priyanshupanchal20/MineVision---Guardian/firmware/README.md

# ESP32-S3 firmware

- `src/main.cpp` — integrated hub (PlatformIO)
- `include/config.h` — pins and thresholds
- `tests/` — Phase 2 single-sensor sketches

```
pio run -t upload
pio device monitor
```
