priyanshupanchal20/MineVision---Guardian/hardware/BOM.md

# Bill of materials (what you already have + consumables)

| Item | Qty | Role |
|---|---|---|
| ESP32-S3-WROOM-N16R8 Dual USB-C | 1 | Vehicle hub |
| TFMini-S | 1 | Forward LiDAR |
| HC-SR04 | 2 | Left / right |
| MLX90640 55° | 1 | Thermal on Pi |
| NEO-6M + ceramic antenna | 1 | Coarse GPS |
| BME280 | 1 | T/RH/P |
| OV7670 | 1 | Stretch; USB webcam preferred for demo |
| LM393 LDR | 1 | Ambient light |
| Waveshare 24 GHz S3KM1110 | 1 | Presence |
| Raspberry Pi 3 B 1 GB | 1 | Fusion + dashboard |
| USB webcam (recommended extra) | 1 | Visibility metrics |
| 5 V 3 A supply / power bank | 1 | Shared rail |
| AMS1117-3.3 (if radar browns out) | 1 | Dedicated 3.3 V |
| 2.2 kΩ + 3.3 kΩ | 2 sets | Echo dividers |
| 330 Ω | 4 | LEDs |
| 1.30" IIC OLED 128×64 (SH1106) | 1 | Cab alerts on ESP32 |
| 5 mm LED G/Y/R + blue | 4 | HUD |
| Active buzzer 3.3–5 V | 1 | Alerts |
| Dupont wires, breadboard or proto | 1 | Lab |
| Optional second ESP32 | 1 | Physical V2V |
| Miniature / RC dumper | 1 | Demo body |

Estimated extra-parts cost beyond sensors you own: **< ₹800** if a USB cam and power bank are already available.
