priyanshupanchal20/MineVision---Guardian/hardware/wiring-diagrams.html

# MineVision Guardian — Hardware Wiring Atlas

SIH 26007 · ESP32-S3-WROOM-N16R8 Dual USB-C · Raspberry Pi 3 B · GPIO numbers, not clone-board silkscreen order. Confirm labels on your PCB.

## 1. System interconnection

Sensors on the ESP32-S3 never share a UART. Thermal and the visible camera live on the Pi. Both boards share GND and a 5 V 3 A rail. Do not power the Pi from the ESP32 5V pin.

5 V 3.3 V GND UART / data Wi-Fi / USB

## 2. Power distribution

Never feed the Raspberry Pi from the ESP32 5V pin. Share GND. Use a 5 V 3 A supply. Star-ground all sensor blacks to the PSU negative.

Optional: AMS1117-3.3 from the 5 V rail + 100 µF if the radar browns out during Wi-Fi TX. 100 nF ceramic on every module VCC.

## 3. ESP32-S3 pins you must not wire

Board: WROOM-1-N16R8 (16 MB flash, 8 MB octal PSRAM), Dual Type-C.

GPIO | Why it is forbidden
19, 20 | Native USB D− / D+ (USB-OTG Type-C)
35, 36, 37 | Octal PSRAM — wiring these crashes or bricks the session
43, 44 (silk TX/RX) | Reserved for TFMini-S. Also tied to COM USB-C — do not add GPS here. Debug on USB-OTG.
26–32 | Flash bus on some modules — leave unused
45, 46 | Strapping / boot mode
0 | BOOT button

Firmware uses USB CDC on USB-OTG for Serial Monitor because silk TX/RX are the LiDAR. Leave the COM Type-C unplugged while ranging.

## 4. ESP32-S3 master GPIO assignment

## 5. TFMini-S LiDAR — silkscreen TX / RX (already occupied)

YD-ESP32-S3: pad TX = GPIO43, pad RX = GPIO44. These two are reserved for the LiDAR. GPS uses GPIO15/16 instead. Plug Serial Monitor into USB-OTG, not COM.

TFMini-S | Board pad | GPIO
Red +5V | 5Vin | —
Black GND | GND | —
Green TX | RX | 44
White RX | TX | 43

## 6. HC-SR04 left and right

Both modules are 5 V. TRIG from 3.3 V GPIO is accepted. ECHO is 5 V — never connect ECHO straight to the ESP32.

## 7. Mandatory ECHO voltage divider (make two)

ECHO — 2.2 kΩ — GPIO — 3.3 kΩ — GND. High level ≈ 5 × 3.3 / (2.2+3.3) = 3.0 V. Safe for ESP32-S3.

## 8. Waveshare S3KM1110 / HMMD 24 GHz (UART0, 115200)

Most Waveshare HMMD modules are 3.0–3.6 V only. 5 V can destroy the radio.

## 9. NEO-6M GPS (UART2, 9600)

UART crossing below matches firmware: Serial2.begin(9600, SERIAL_8N1, 15, 16) → ESP RX=GPIO15, ESP TX=GPIO16. Do not use the pads labelled TX and RX — those are already the TFMini-S. Indoor gps_valid=false is normal. Not centimetre RTK.

The u-blox NEO-6M chip is 3.3 V. Only put 5 V on VCC if the breakout has an onboard regulator (silkscreen often says “3.3–5V”). A 3.3 V-only board + 5 V will kill it. TX/RX are 3.3 V logic — do not assume GPS TX is 5 V tolerant into the ESP32 (clone TX is usually 3.3 V, which is correct).

NEO-6M pin | Goes to | Must be true
VCC | ESP32 3V3 if board says 3.3 V only; ESP32 5V only if board says 3.3–5 V / has LDO | Read YOUR silkscreen. Chip max is 3.6 V.
GND | ESP32 GND | Required. UART will not work with floating ground.
TX | GPIO15 (ESP RX) | Crossed. If you wire TX–TX you get silence.
RX | GPIO16 (ESP TX) | Crossed. Needed only if you send config; still wire it.
PPS | not connected | Optional 1 Hz pulse — unused in this firmware.

This is not “any clone, guaranteed”. If Serial shows chars=0, TX/RX are swapped or baud is 38400 on that module — try swapping 15/16 first, then baud. Cold start outdoors can take up to ~15 minutes. Ceramic / u.FL antenna must be fitted. Keep it ≥ 5 cm from the ESP32 PCB antenna or Wi-Fi will starve the receiver.

## 10. BME280 (I2C0) — YD-ESP32-S3 pins 8 and 9

I2C is not crossed: SDA→SDA, SCL→SCL. Do not use silk TX/RX (those are TFMini-S). Firmware: Wire.begin(8, 9), addresses 0x76 and 0x77.

Power from board 3V3, not 5Vin, unless your BME280 breakout has a regulator and the silkscreen says 5 V is allowed. The sensor chip is 3.3 V.

BME280 pin | YD-ESP32-S3 pad | GPIO
VCC / VIN / 3.3V | 3V3 | —
GND | GND | —
SDA | 8 | 8
SCL | 9 | 9
SDO (optional) | GND for 0x76, or 3V3 for 0x77 | —
CSB / CS (if present) | tie to 3V3 to force I2C mode | —

Most modules already have 4.7 kΩ pull-ups. If BME280 not found, check 3.3 V (not 5 V), SDA/SCL not swapped, and CSB high. Test sketch: firmware/tests/04_bme280/.

## 10b. MPU-6050 (I2C1) — pads 17 and 18, not 8/9

BME280 and the 1.3" OLED share pads 8 and 9. MPU-6050 uses a second I2C bus on pads 17 (SDA) and 18 (SCL). Those were freed when TFMini-S moved to silk TX/RX. Firmware: Wire1.begin(17, 18).

VCC = board 3V3, not 5Vin. Tie AD0 to GND (address 0x68). Do not unplug the BME280 or OLED from 8/9 to free MPU pins — MPU has its own bus.

MPU-6050 pin | YD-ESP32-S3 pad | GPIO
VCC | 3V3 | —
GND | GND | —
SDA | 17 | 17
SCL | 18 | 18
AD0 | GND | address 0x68
INT, XDA, XCL | not connected | —

## 11. LM393 LDR module

Mount sky-facing, not in the LED glare. If raw values invert on your board, swap the map() ends in firmware.

## 12. Operator LEDs and buzzer

## 12b. 1.30" IIC OLED cab alerts (SH1106 128×64)

This is the module you have: front silk VCC GND SCK SDA (left → right). SCK is I2C clock (SCL), not SPI. Four wires. Shares I2C0 with the BME280. Runs on the ESP32 even if the Pi is unplugged. Do not use pads 17/18 (MPU-6050).

Test sketch: firmware/tests/10_oled_i2c/. Peel the blue protective film before judging contrast.

## 13. Raspberry Pi 3 Model B — 40-pin header (used pins)

Enable I2C: sudo raspi-config → Interface Options → I2C. Confirm with sudo i2cdetect -y 1 (expect 33).

## 14. MLX9064X thermal (MLX90640 / MLX90641) — Raspberry Pi 3, not ESP32

Do not put this on ESP32 pads 8/9 (BME280 + OLED) or 17/18 (MPU-6050). The 32×24 (or 16×12) array is processed on the Pi. Same 4 wires for MLX90640 and MLX90641. I2C address 0x33.

VIN = Pi 3.3 V (physical pin 1) only. 5 V will destroy the array. I2C is SDA→SDA, SCL→SCL — not crossed. Enable I2C: sudo raspi-config → Interface → I2C.

MLX9064X pin | Pi 3 physical pin | BCM
VIN / VDD / 3V3 | 1 (3V3, corner by the SD card) | —
GND | 6 | —
SDA | 3 | GPIO2
SCL | 5 | GPIO3

Do not use Pi pin 2 or 4 (those are 5 V). Test: firmware/tests/02_mlx90640/02_mlx90640.py.

## 15. OV7670 visible camera — Raspberry Pi 3, not ESP32

ESP32 pads are full. MLX9064X already uses Pi pins 1 / 3 / 5 / 6. OV7670 uses the mapping below. 3.3 V only — never Pi pins 2 or 4. For the judge demo, a USB webcam is the reliable path.

OV7670 | Pi pin | From left of J8 | BCM
3.3V | 17 | Inner, 9th | 3V3
GND | 9 | Inner, 5th | GND
SIOD | 19 | Inner, 10th | GPIO10
SIOC | 23 | Inner, 12th | GPIO11
XCLK | 7 | Inner, 4th | GPIO4
PCLK | 15 | Inner, 8th | GPIO22
VSYNC | 13 | Inner, 7th | GPIO27
HREF / HS | 11 | Inner, 6th | GPIO17 (HS is HREF)
RESET / RET | 18 | Outer, 9th | GPIO24 (RET is RESET)
PWDN | 16 | Outer, 8th | GPIO23
D0–D7 | 29 31 33 35 37 36 38 40 | — | 5 6 13 19 26 16 20 21

## 16. Assembly order and common ground

1. Build both ECHO dividers on protoboard and verify ~3.0 V with a 5 V pulse (or continuity) before touching the ESP32.
2. Connect all GNDs to the PSU negative (star), including Pi GND if you share the 5 V buck.
3. Wire 3.3 V sensors (BME, LDR, radar) and power the ESP32 from USB. Run Phase 2 tests one device at a time.
4. Add 5 V sensors (LiDAR, ultrasonics) on the 5 V rail, not from a weak USB-UART port if current sags.
5. Connect Pi + MLX90640 + USB cam on their own 5 V input. Join GND to the ESP32/PSU star.
6. Wi-Fi: phone hotspot or Pi AP. Set GATEWAY_HOST to the Pi IP.

### UART discipline

Always TX → RX and RX → TX. I2C is SDA → SDA, SCL → SCL.

### Cable length

LiDAR and radar < 50 cm. I2C < 30 cm. GPS antenna clear of metal and the ESP32 antenna.

### Firmware match

These GPIO numbers are exactly firmware/include/config.h. If you move a wire, change that file and the matching test sketch.

## Quick table (print this last page)

Device | Power | Signal to ESP32-S3 / Pi
TFMini-S | 5 V | green→silk RX (44), white→silk TX (43)
NEO-6M | 5 V or 3.3 V | TX→15, RX←16
S3KM1110 | 3.3 V | TX→11, RX←10, OUT→12
BME280 | 3.3 V | SDA 8, SCL 9 (shared with OLED)
1.3" OLED | 3.3 V | VCC 3V3, SCK→9, SDA→8, addr 0x3C
MPU-6050 | 3.3 V | SDA 17, SCL 18, AD0 GND (0x68)
LDR | 3.3 V | A0→4
HC-SR04 L | 5 V | TRIG 13, ECHO 7 via divider
HC-SR04 R | 5 V | TRIG 21, ECHO 47 via divider
LEDs | GPIO + 330 Ω | G1 Y2 R42 FOG41
Buzzer | GPIO | GPIO6
MLX90640 | Pi 3V3 | SDA pin3, SCL pin5
USB camera | Pi USB | UVC
