priyanshupanchal20/MineVision---Guardian/firmware/tests/12_fresh_bench/README.md

# Fresh sensor bench

External **5 V + common GND** for TFMini, both HC-SR04, and GPS (if silk allows 5 V). OLED/BME/MPU on **3V3**. USB-OTG for Serial. No radar, no motors.
